rafaellehmkuhl/Placas-Bancada-Mitica/bancada_pitot/bancada_pitot.brd

## EAGLE design bancada_pitot/bancada_pitot.brd (2018-05-18)

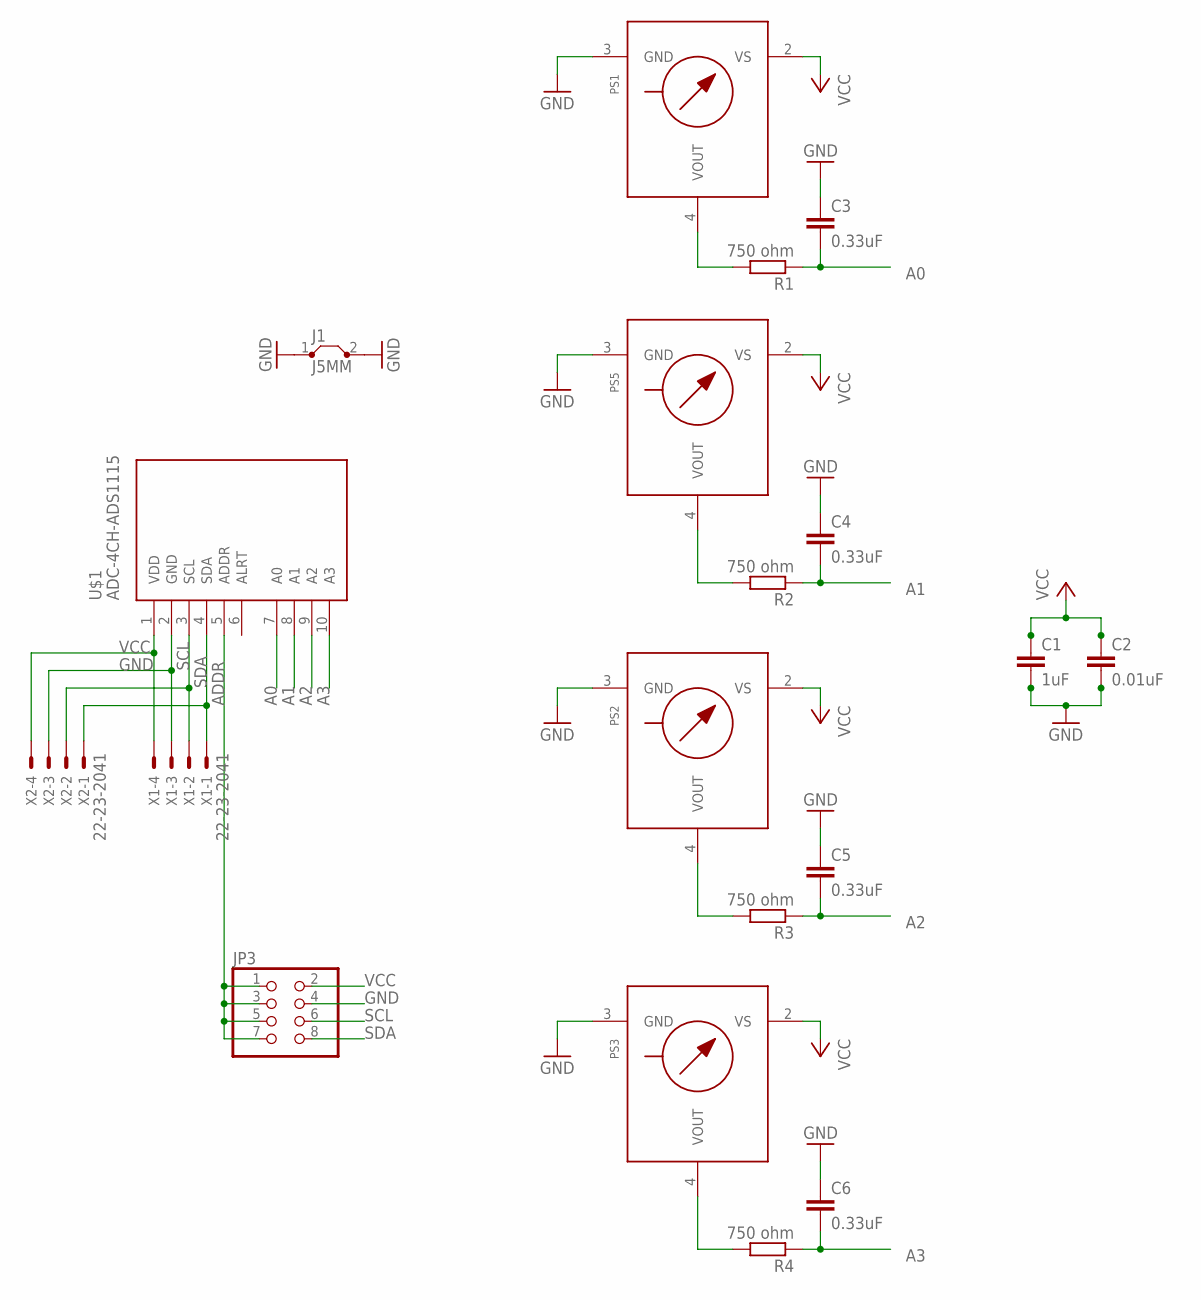
[picture p5: schematic bancada_pitot.sch]

Parts:
C1: 1uF; C025-025X050
C2: 0.01uF; C025-025X050
C3, C4, C5, C6: 0.33uF; C025-025X050
J1: J5MM; 05
JP3: PINHD-2X4; 2X04
PS1, PS2, PS3, PS5: MPX-1351; 1351
R1, R2, R3, R4: 750 ohm; 0207/2V
U$1: ADC-4CH-ADS1115
X1, X2: 22-23-2041

Connections:
A0: C3.2, R1.1, U$1.7 (A0)
A1: C4.2, R2.1, U$1.8 (A1)
A2: C5.2, R3.1, U$1.9 (A2)
A3: C6.2, R4.1, U$1.10 (A3)
ADDR: JP3.1, JP3.3, JP3.5, JP3.7, U$1.5 (ADDR)
GND: C1.2, C2.2, C3.1, C4.1, C5.1, C6.1, J1.1, J1.2, JP3.4, PS1.3 (GND), PS2.3 (GND), PS3.3 (GND), PS5.3 (GND), U$1.2 (GND), X1.3, X2.3
unnamed: PS1.4 (VOUT), R1.2
unnamed: PS5.4 (VOUT), R2.2
unnamed: PS2.4 (VOUT), R3.2
unnamed: PS3.4 (VOUT), R4.2
SCL: JP3.6, U$1.3 (SCL), X1.2, X2.2
SDA: JP3.8, U$1.4 (SDA), X1.1, X2.1
VCC: C1.1, C2.1, JP3.2, PS1.2 (VS), PS2.2 (VS), PS3.2 (VS), PS5.2 (VS), U$1.1 (VDD), X1.4, X2.4

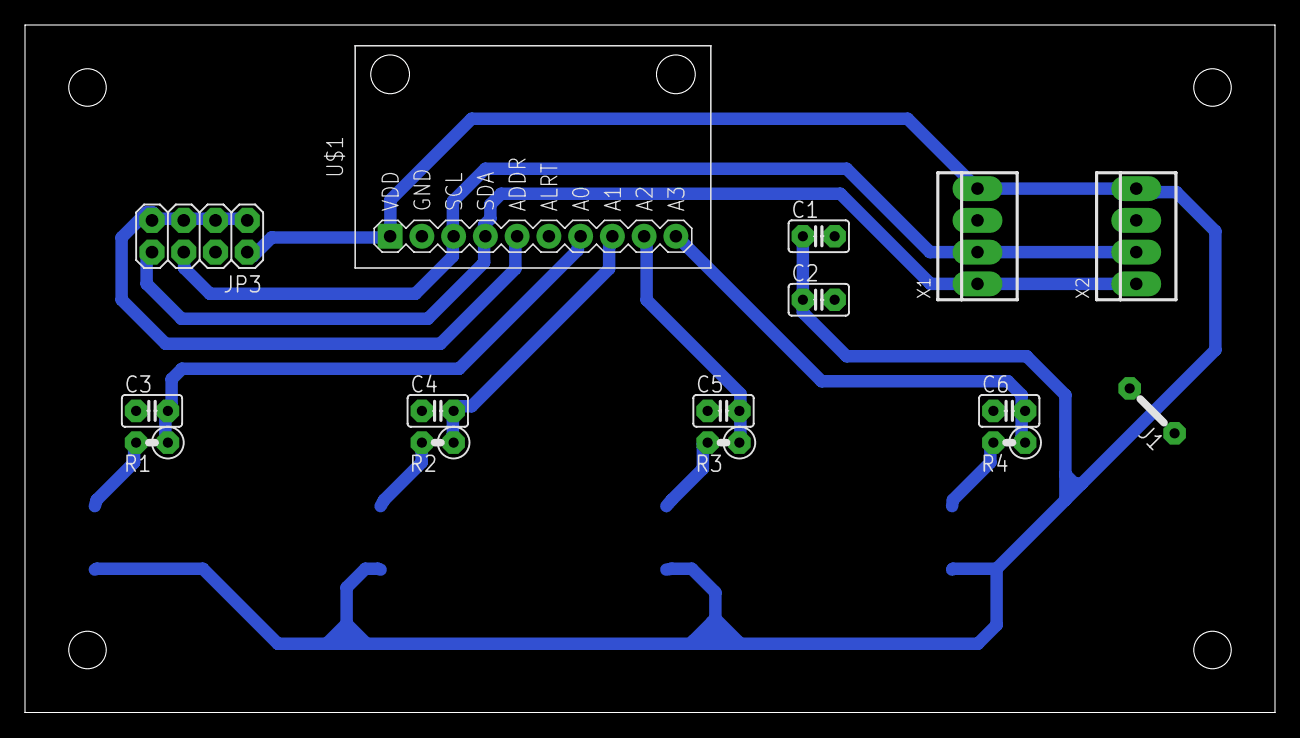
[picture p6: board bancada_pitot.brd from above]

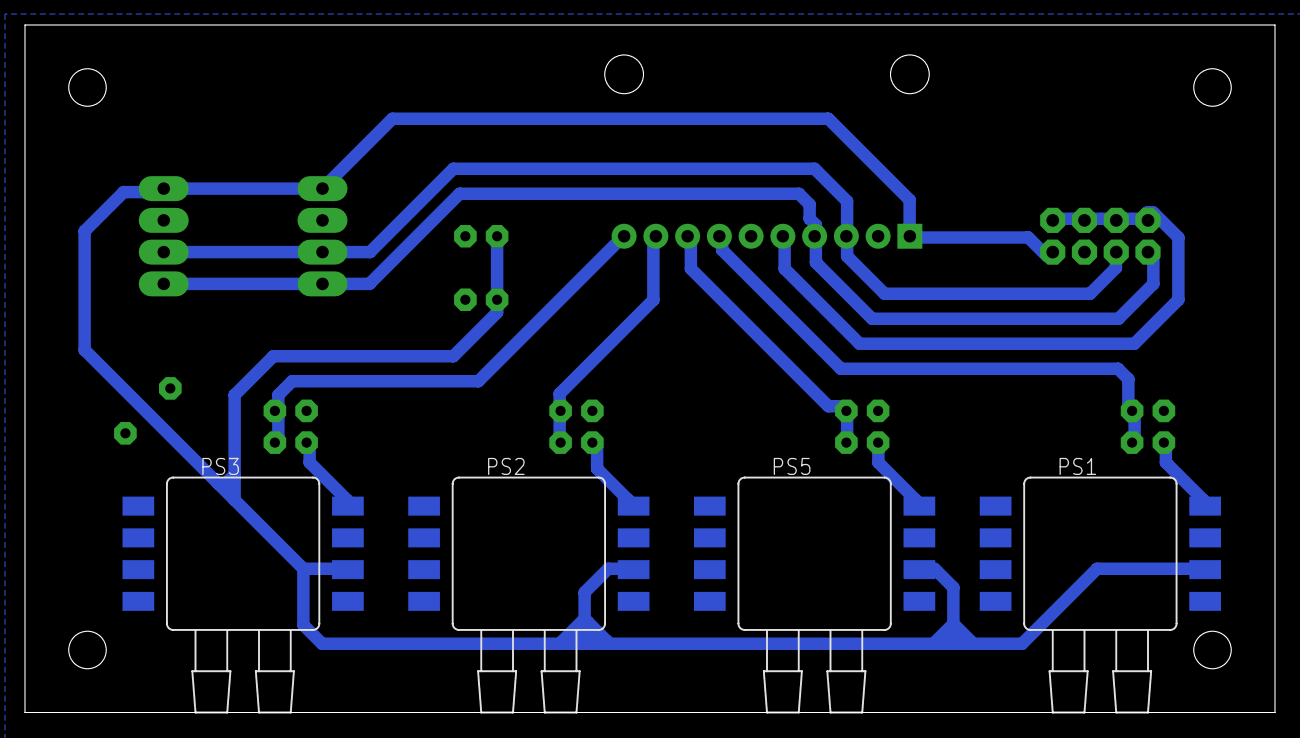
[picture p7: board bancada_pitot.brd from below]

Board: 2 copper layers, 100.0 x 55.0 mm, 19 parts (4 on the bottom side), 13 nets.
