rafaellehmkuhl/Placas-Bancada-Mitica/bancada_celulas/bancada_hx711.brd

## EAGLE design bancada_celulas/bancada_hx711.brd (2018-05-18)

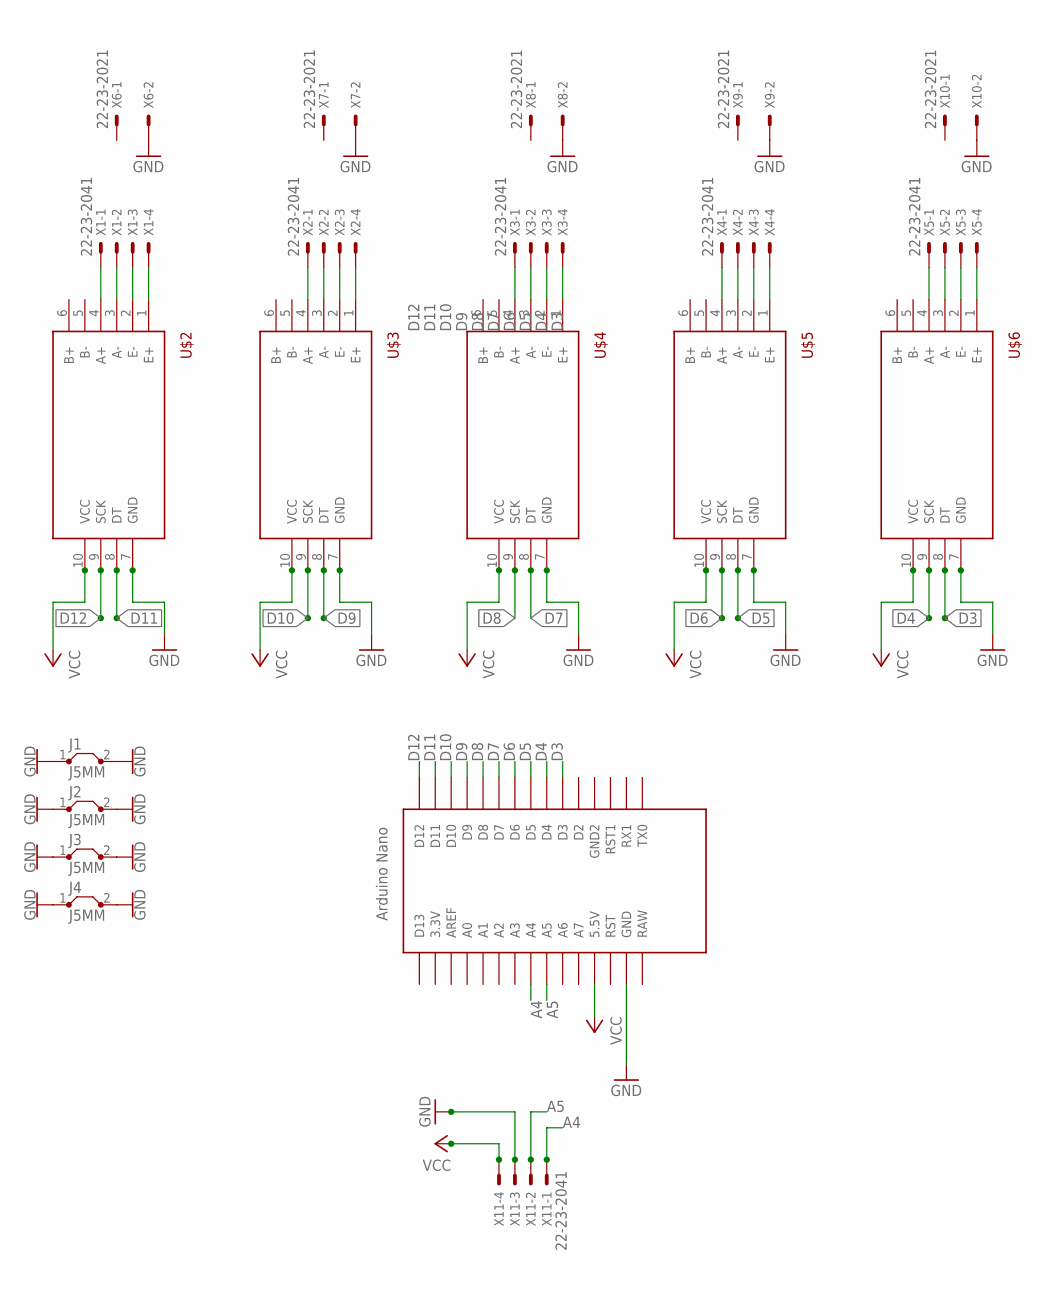
[picture p8: schematic bancada_hx711.sch]

Parts:
J1, J2, J3, J4: J5MM; 05
U$1: NANO
U$2, U$3, U$4, U$5, U$6: HX711-1
X1, X2, X3, X4, X5, X11: 22-23-2041
X6, X7, X8, X9, X10: 22-23-2021

Connections:
A4: U$1.A4, X11.1
A5: U$1.A5, X11.2
D3: U$1.D3, U$6.8 (DT)
D4: U$1.D4, U$6.9 (SCK)
D5: U$1.D5, U$5.8 (DT)
D6: U$1.D6, U$5.9 (SCK)
D7: U$1.D7, U$4.8 (DT)
D8: U$1.D8, U$4.9 (SCK)
D9: U$1.D9, U$3.8 (DT)
D10: U$1.D10, U$3.9 (SCK)
D11: U$1.D11, U$2.8 (DT)
D12: U$1.D12, U$2.9 (SCK)
GND: J1.1, J1.2, J2.1, J2.2, J3.1, J3.2, J4.1, J4.2, U$1.GND, U$2.7 (GND), U$3.7 (GND), U$4.7 (GND), U$5.7 (GND), U$6.7 (GND), X6.2, X7.2, X8.2, X9.2, X10.2, X11.3
unnamed: U$2.1 (E+), X1.4
unnamed: U$2.2 (E-), X1.3
unnamed: U$2.3 (A-), X1.2
unnamed: U$2.4 (A+), X1.1
unnamed: U$3.4 (A+), X2.1
unnamed: U$3.3 (A-), X2.2
unnamed: U$3.2 (E-), X2.3
unnamed: U$3.1 (E+), X2.4
unnamed: U$4.1 (E+), X3.4
unnamed: U$4.2 (E-), X3.3
unnamed: U$4.3 (A-), X3.2
unnamed: U$4.4 (A+), X3.1
unnamed: U$5.1 (E+), X4.4
unnamed: U$5.2 (E-), X4.3
unnamed: U$5.3 (A-), X4.2
unnamed: U$5.4 (A+), X4.1
unnamed: U$6.1 (E+), X5.4
unnamed: U$6.2 (E-), X5.3
unnamed: U$6.3 (A-), X5.2
unnamed: U$6.4 (A+), X5.1
VCC: U$1.5V (5.5V), U$2.10 (VCC), U$3.10 (VCC), U$4.10 (VCC), U$5.10 (VCC), U$6.10 (VCC), X11.4

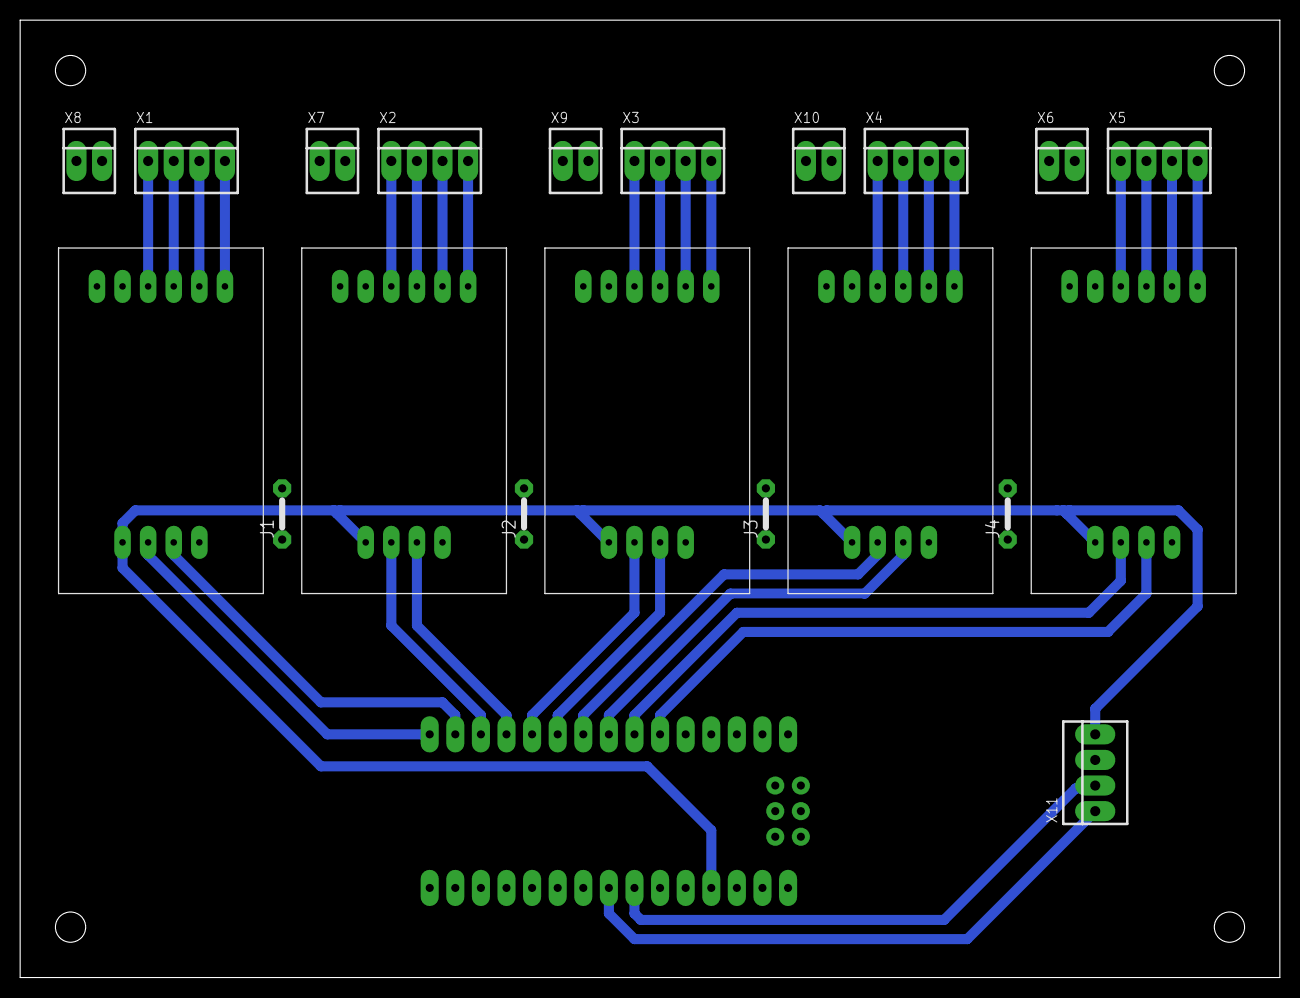
[picture p9: board bancada_hx711.brd from above]

Board: 2 copper layers, 125.0 x 95.0 mm, 21 parts (0 on the bottom side), 34 nets.
