rafaellehmkuhl/Placas-Bancada-Mitica/(commit log)

2018-03-15 Add first version of pitot and nano/hx711 boards
    [bancada_hx711_5.brd, bancada_hx711_5.sch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]
2018-03-16 Correct the name for many files
    [bancada_hx711.brd, bancada_hx711.sch, bancada_pitot.brd, bancada_pitot.sch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]
2018-03-16 Generate new gerber and drill files
    Since Eagle v8 has a bug regarding the generation of gerber and drill files, those files were generated from Eagle v6. The new versions are here.
2018-03-22 KK connectors changed from 4mm to 2.54mm
    [bancada_hx711.brd, bancada_hx711.sch, bancada_pitot.brd, bancada_pitot.sch]
2018-03-27 Increase the width of the grounded pins bridges and update DRC
    The connections between the GND pins and the GND plane were too thin, so on the milling process they ended up not connected.
    To solve this problem the width of those bridges were increased from 0.1016mm to 0.762mm changinf the GND polygon to 1.016mm width.
    A new DRC was created as is used by both boards.
    [bancada_hx711.brd, bancada_pitot.brd]
2018-04-30 Name A4 and A5 lines
    A4 and A5 lines were hardwired. They are now named A4 and A5.
    [bancada_hx711.sch]
2018-04-30 Correct position for edge lines
    Both top and right edge lines were bad positioned, in a way that the four board holes were not the same distance from the edges. This makes dificult to position them on CAD files for posterior case modeling.
    Now the holes are 150mil apart from each edge.
    [bancada_hx711.brd, bancada_pitot.brd]
2018-05-18 Add jumpers (or 0ohm resistors)
    In previous design, some ground planes were unconnected to each other. It was meant to be added jumper wires after production.
    This commit changes this to actual jumpers, with pins, so they don't need to be soldered from bottom, but can actually be placed on top, like any other through-hole component. 0ohm through-hole resistors can also be used.
    [bancada_hx711.brd, bancada_hx711.sch, bancada_pitot.brd, bancada_pitot.sch]
2018-05-18 Change board edges and holes
    Edges and holes are supossed to be in "mm", different from the components and traces, that should follow "mil" units.
    This way we the board respects the board manufacturer (who uses mil system) as well as the CAD designer (who uses metric system).
    [bancada_hx711.brd, bancada_pitot.brd]
2018-05-18 Update README with description and images
    Update description and add images from boards.
